ShobithBR/Nightfall-EX-Advanced-An-Offline-TinyML-Based-Portable-ECG-Monitoring-and-Emergency-Alert-System/images/Top view of the assembled prototype.png

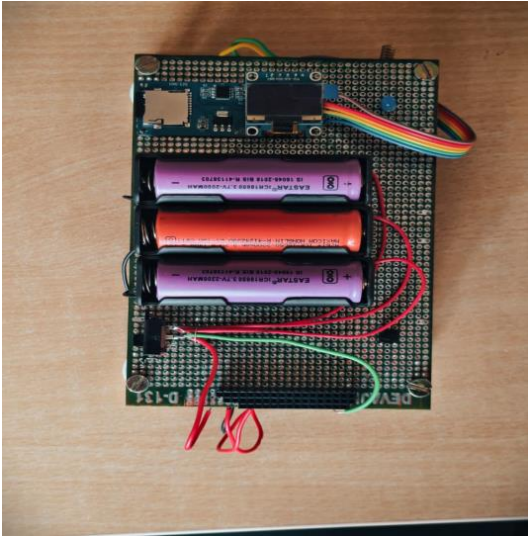
images/Top view of the assembled prototype.png
