ShobithBR/Nightfall-EX-Advanced-An-Offline-TinyML-Based-Portable-ECG-Monitoring-and-Emergency-Alert-System/images/ECG waveform output displayed on OLED screen.png

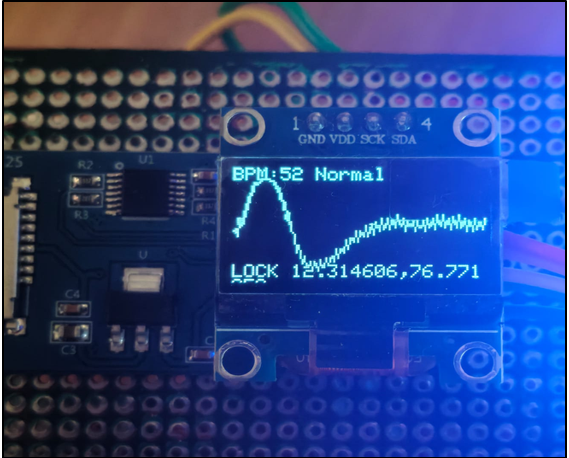
images/ECG waveform output displayed on OLED screen.png
