ShobithBR/Nightfall-EX-Advanced-An-Offline-TinyML-Based-Portable-ECG-Monitoring-and-Emergency-Alert-System/diagrams/architecture_flowchart.png

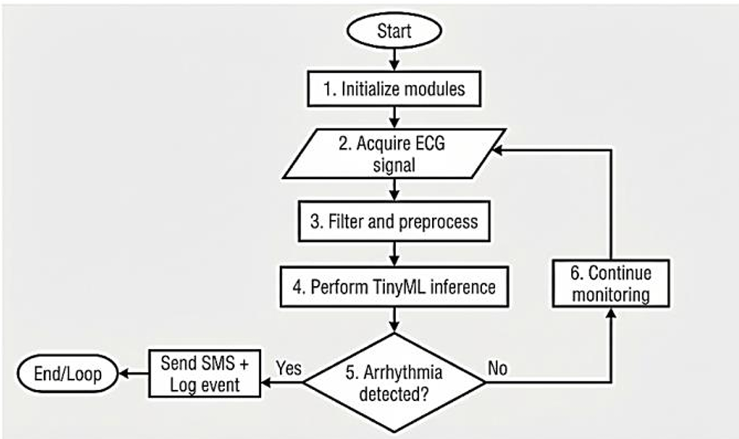
diagrams/architecture_flowchart.png
