ShobithBR/Nightfall-EX-Advanced-An-Offline-TinyML-Based-Portable-ECG-Monitoring-and-Emergency-Alert-System/diagrams/block_diagram.png

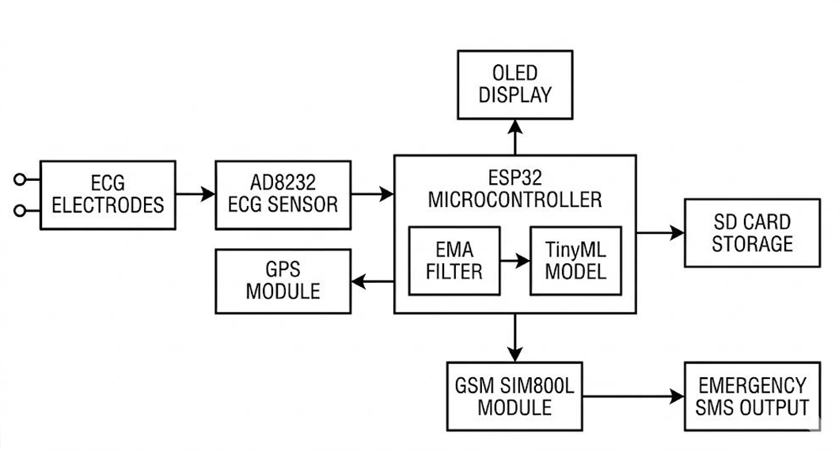
diagrams/block_diagram.png
