ShobithBR/Nightfall-EX-Advanced-An-Offline-TinyML-Based-Portable-ECG-Monitoring-and-Emergency-Alert-System/images/ECG Raw Data Visualization (Edge Impulse).png

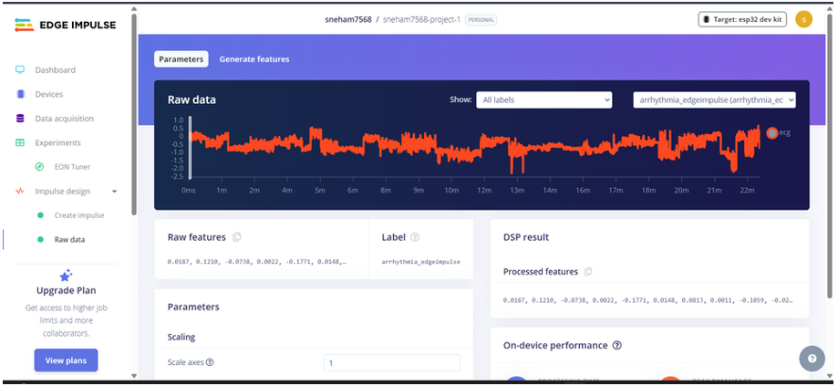
images/ECG Raw Data Visualization (Edge Impulse).png
