ShobithBR/Nightfall-EX-Advanced-An-Offline-TinyML-Based-Portable-ECG-Monitoring-and-Emergency-Alert-System/images/ECG Signal Feature Extraction.png

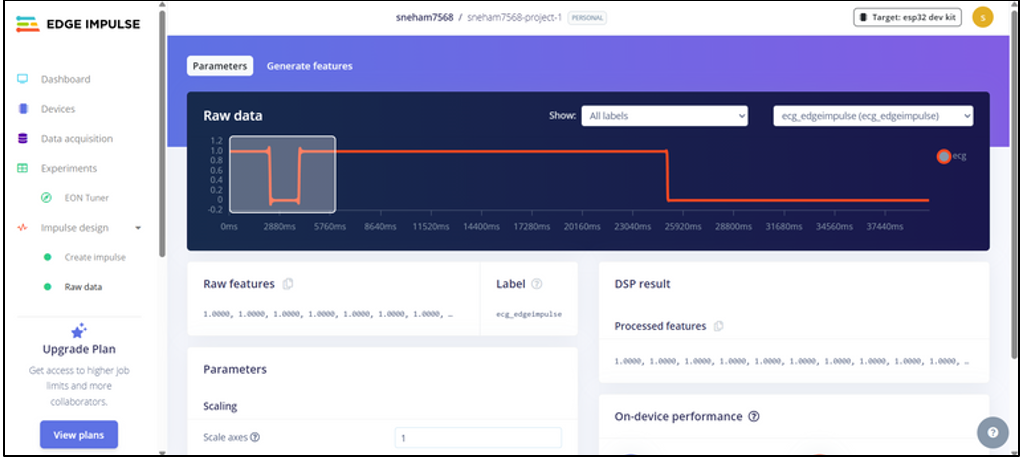
images/ECG Signal Feature Extraction.png
