ShobithBR/Nightfall-EX-Advanced-An-Offline-TinyML-Based-Portable-ECG-Monitoring-and-Emergency-Alert-System/images/Example of SMS alert received on mobile phone.png

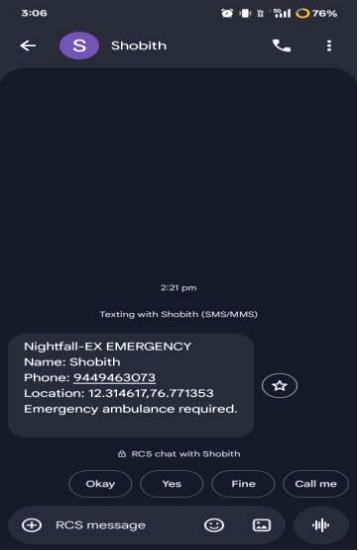
images/Example of SMS alert received on mobile phone.png
