ShobithBR/Nightfall-EX-Advanced-An-Offline-TinyML-Based-Portable-ECG-Monitoring-and-Emergency-Alert-System/images/Feature Distribution & Data Explorer.png

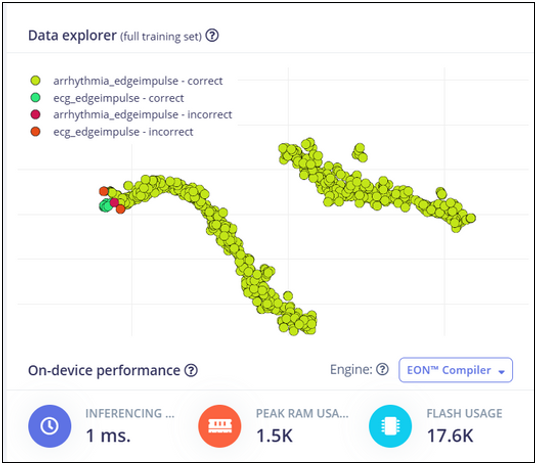
images/Feature Distribution & Data Explorer.png
