ShobithBR/Nightfall-EX-Advanced-An-Offline-TinyML-Based-Portable-ECG-Monitoring-and-Emergency-Alert-System/images/GPS coordinates received during testing.png

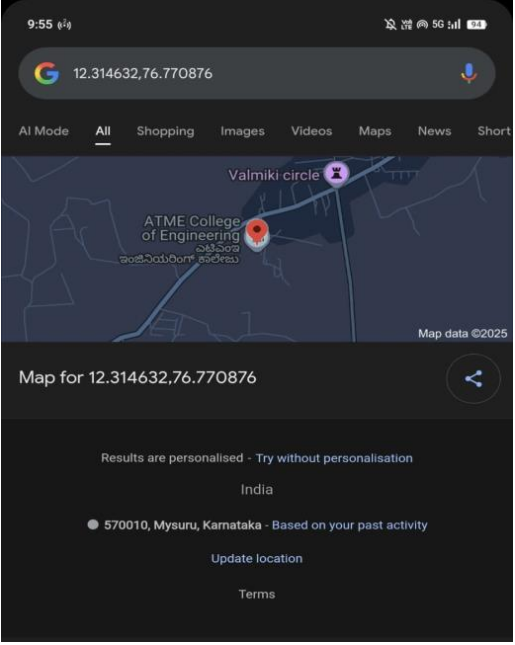
images/GPS coordinates received during testing.png
