ShobithBR/Nightfall-EX-Advanced-An-Offline-TinyML-Based-Portable-ECG-Monitoring-and-Emergency-Alert-System/images/Model Performance & Accuracy Metrics.png

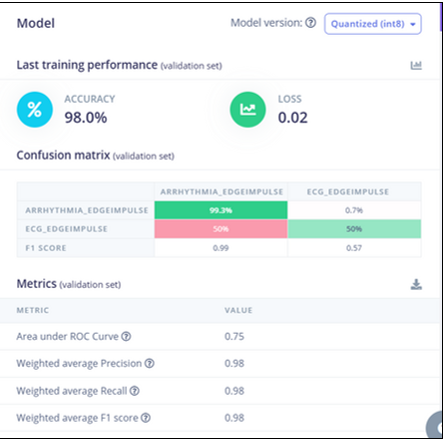
images/Model Performance & Accuracy Metrics.png
