ShobithBR/Nightfall-EX-Advanced-An-Offline-TinyML-Based-Portable-ECG-Monitoring-and-Emergency-Alert-System/(commit log)

2026-04-07 README with system details and instructions
    - Added full project README with hardware components, pin connections,
    power architecture, TinyML model performance, and reproduction steps
    - Corrected power architecture to dual 18650 Li-ion battery system
    (Battery 1 → ESP32, AD8232, OLED, MicroSD | Battery 2 → GPS, SIM800L)
    - Removed incorrect LM2596 and TP4056 references
    - Added system performance metrics table (93.4% accuracy, 18-22ms inference)
    - Added TinyML classification results table and sample data log table
    - Added comparison table vs existing cloud/smartphone ECG systems
    - Added demo video
    - Added project structure, reproduction steps, and disclaimer
    - Authors: Shobith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
2026-04-07 README with project details and specifications
    Expanded README to include detailed project description, problem statement, key features, system performance metrics, hardware components, pin connections, and power architecture.
2026-04-08 System Implementation and Experimental Results
    These images illustrate the complete development and testing of the ECG monitoring system, including signal acquisition, feature extraction, and model performance. The hardware prototype, OLED output, and GSM-based emergency alerts demonstrate real-time functionality. GPS integration further enables accurate location tracking during emergency situations.
2026-04-08 System Code Implementation
    This code implements the complete functionality of the ECG monitoring system using ESP32, integrating ECG signal acquisition, GPS tracking, GSM communication, and OLED display. It also includes Edge Impulse-based inference for arrhythmia detection and SD card logging for data storage.
2026-04-08 Update GPIO pin assignments in README.md
2026-04-08 diagrams and circuits
    Added four hardware diagrams to directory:
    - architecture_flowchart.png : System-level architecture showing
    data flow between ESP32, ECG sensor,
    GPS, GSM, OLED, and MicroSD modules
    - block_diagram.png : High-level block diagram of the
    CardioByte IoT ECG & GPS Tracker
    hardware components and connections
    - circuit_schematic.png : Full Altium-style circuit schematic
    with GPIO pin mappings, power rails,
    dual 18650 battery architecture,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
2026-04-08 Requried libraries
    required libraries that has to be installed in the Arduino IDE before uploading the code to the system .
